wangmiaolzz/My-graduation-project/毕设/图纸/3D/差速器壳.SLDPRT

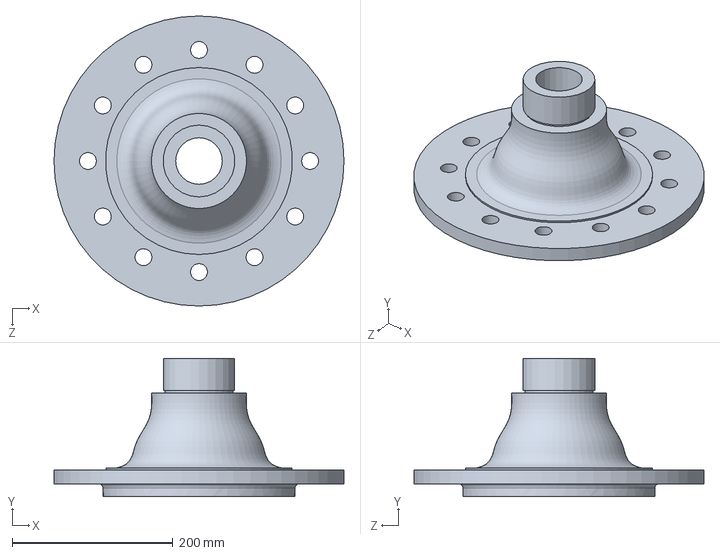
[picture p7: CAD file, 2016-06-03]
毕设/图纸/3D/差速器壳.SLDPRT
360.4 x 171.7 x 360.4 mm
