wangmiaolzz/My-graduation-project/毕设/图纸/3D/零件8.SLDPRT

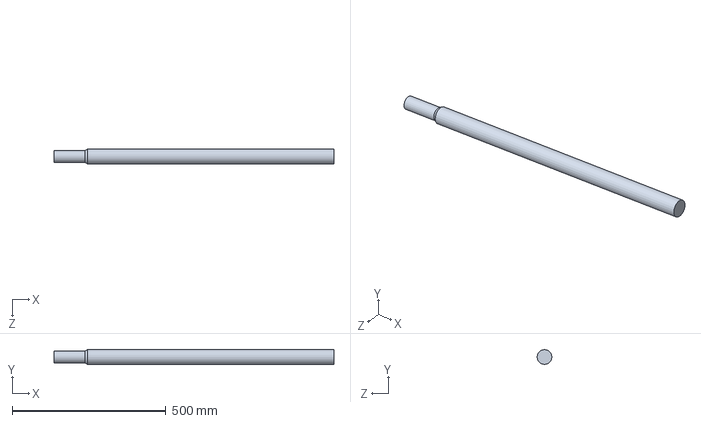
[picture p8: CAD file, 2016-06-03]
毕设/图纸/3D/零件8.SLDPRT
910.0 x 48.0 x 48.0 mm
