wangmiaolzz/My-graduation-project/毕设/图纸/3D/中间轴.SLDPRT

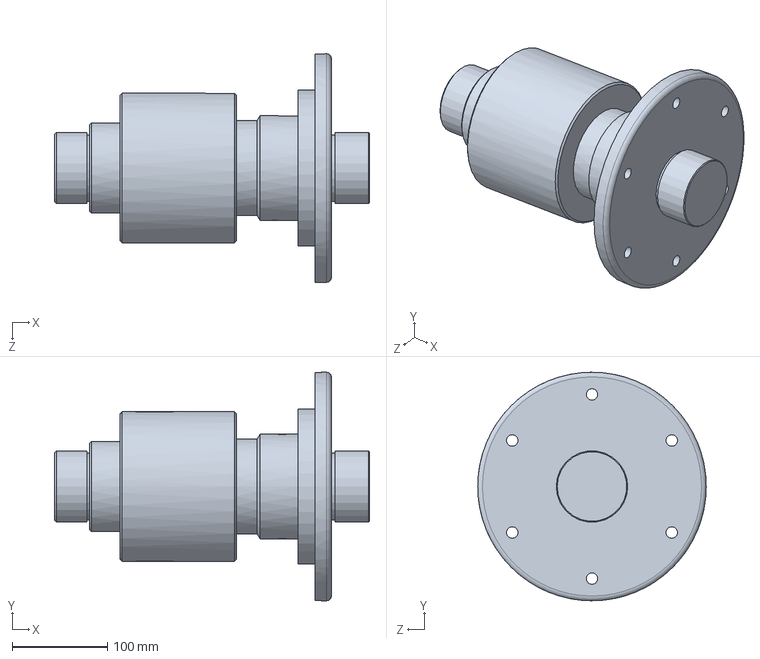
[picture p9: CAD file, 2016-06-03]
毕设/图纸/3D/中间轴.SLDPRT
330.8 x 240.0 x 240.0 mm
