wangmiaolzz/My-graduation-project/毕设/图纸/3D/主动锥齿轮.SLDPRT

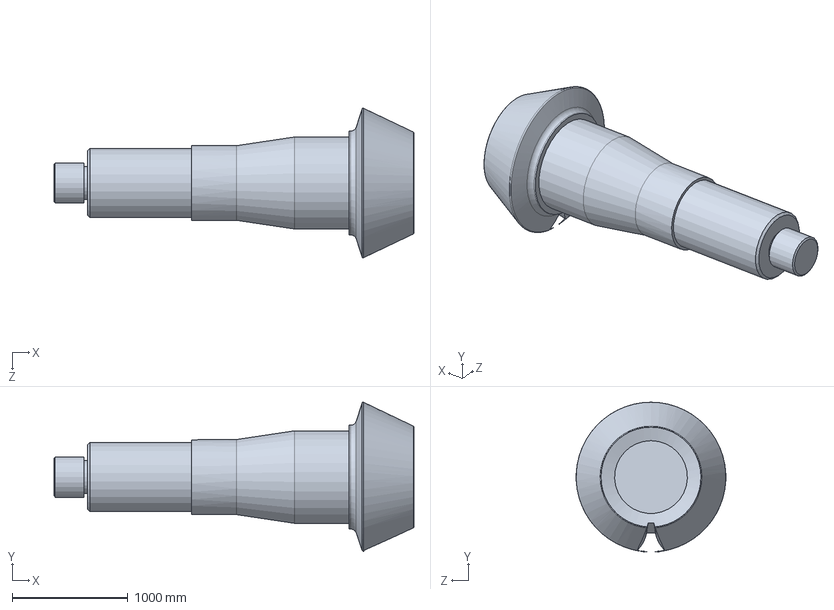
[picture p10: CAD file, 2016-06-03]
毕设/图纸/3D/主动锥齿轮.SLDPRT
3116.0 x 1295.4 x 1295.1 mm
