wangmiaolzz/My-graduation-project/(list of files, cad)

Other CAD files:
毕设/图纸/3D/差速器壳.DWG
